NithujanSel/FarmLabCameraSlider/README.md

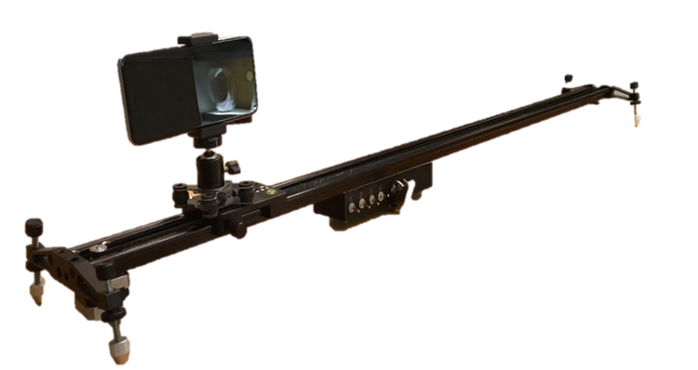
[picture p1: docs/assets/media/image1.png]


# Camera slider

### Student 1: Nithujan Selvaratnam

### Student 2: Jesse Denaux

### Student 3: Tarun Singh

<a href="https://nithujansel.github.io/FarmLabCameraSlider/">Docsify Page</a><br>
