NithujanSel/FarmLabCameraSlider/docs/README.md

# Documentatie

## Camera slider

### Student 1: Nithujan Selvaratnam

### Student 2: Jesse Denaux

### Student 3: Tarun Singh
