NithujanSel/FarmLabCameraSlider/docs/_sidebar.md

<!-- docs/_sidebar.md -->

* [Documentatie Camera slider](./documentatie/index)
