NithujanSel/FarmLabCameraSlider/docs/documentatie/index.md

# Documentatie

# Stand

De stand moet zo ontworpen zijn dat het het profiel op een bepaalde
afstand van de grond zal houden en stevig genoeg is om het geheel
stabiel te houden. Er is gekozen om dit te 3D printen zodat de
onderzoeker vrij is in het ontwerp en snel aanpassingen kan doen indien
nodig. Het eerste ontwerp was een rechthoek waar het profiel door past
met twee beentjes die naar de grond gaan voor stabiliteit. Na een eerste
revisie werd al snel besloten om de bovenste hoeken van de rechthoek af
te kappen omdat deze geen extra nut hebben en dit enkel maar langer
duurt om te printen.

## Stand 1 v1

In het eerste ontwerp is er gekeken naar de grootte van het profiel. Om
te zien dat de stand hier vlot kan inschuiven is er een marge van 0.2 mm
genomen. Het ging hier vooral over of de stand past en of dit stevig is.
Dit is ook maar met een breedte van 1 cm geprint om ervoor te zorgen dat
dit niet zolang moest printen.

<iframe
src="https://myap83.autodesk360.com/shares/public/SH35dfcQT936092f0e43ae2769a1c0cda5d8?mode=embed"
width="640" height="480" allowfullscreen="true"
webkitallowfullscreen="true" mozallowfullscreen="true"
frameborder="0"\>\</iframe>

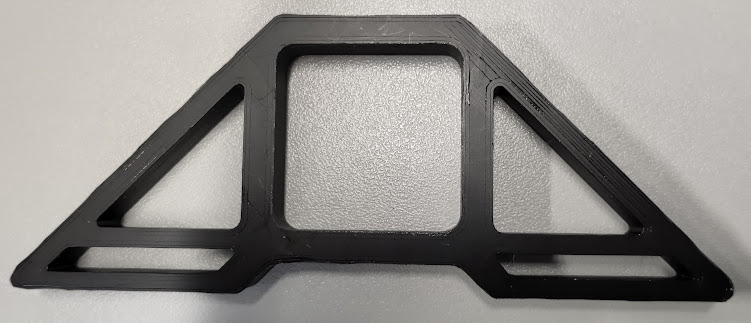
[picture p2: docs/assets/media/image2.png]
Stand 1 v1


Figuur 1: Eerste prototype profielstand 1

## Stand 1 v2

De grootte van het gat waar het profiel in past was net iets te groot.
Om dit op te lossen is het gat in de breedte en de hoogte met 0.1mm
verkleind. Voor de rest is de stevigheid van de stand perfect. Hier moet
er niets meer aan worden aangepast.

Om ervoor te zorgen dat onze slider heen en weer kan bewegen wordt er
gebruik gemaakt van een rubberen ketting. Deze ketting wordt dan met een
pulley wheel met tanden (Afbeelding 3) strak gehouden. Deze pulley wordt
aan de stand vastgemaakt. Hiervoor wordt er een kleine rechthoek op de
stand gemaakt waar de pulley in past.

<iframe
src="https://myap83.autodesk360.com/shares/public/SH35dfcQT936092f0e43b2dbe0e7d11261af?mode=embed"
width="640" height="480" allowfullscreen="true"
webkitallowfullscreen="true" mozallowfullscreen="true"
frameborder="1"\>\</iframe>

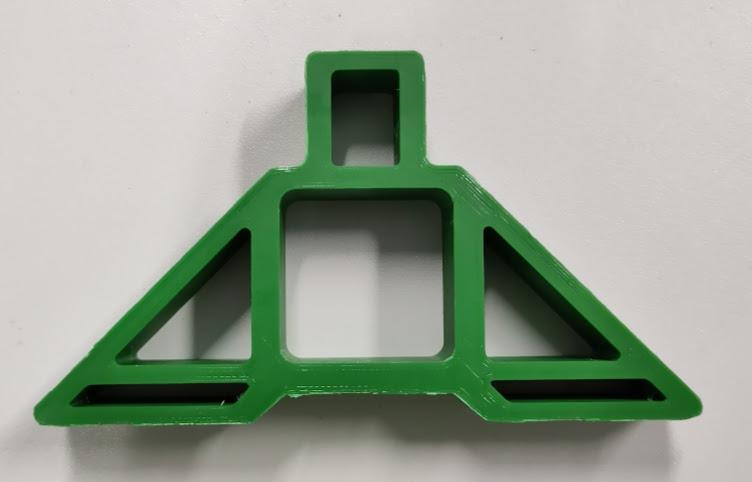
[picture p3: docs/assets/media/image3.png]
Stand 1 v2


Figuur 2: Tweede prototype profielstand 1

## Stand 1 v3

Het rechthoek van de pulley is nog net iets te groot. Hierdoor kan de
pulley een beetje in de breedte bewegen. Er is een speling van 1.87mm.
De rechthoek wordt verkleind met 1mm in de breedte zodat de pulley
minder speling heeft. De hoogte van de stand wordt 2mm groter gemaakt
zodat het profiel iets hoger van de grond is. Als laatste waren de gaten
waar de bout doorgaat om de pulley vast te hangen niet op gelijke
hoogte. Dit was een verschil van 0.2mm wat niet zo groot is maar dit was
wel zichtbaar met het oog.

Om ervoor te zorgen dat de stand aan het profiel kan worden vastgemaakt
is er in het midden aan de onderkant een gat gemaakt waar een bout door
kan. Met een moer kan dit dan aan het profiel worden vatgemaakt.

<iframe
src="https://myap83.autodesk360.com/shares/public/SH35dfcQT936092f0e43e49b220a03c161df?mode=embed"
width="640" height="480" allowfullscreen="true"
webkitallowfullscreen="true" mozallowfullscreen="true"
frameborder="0"\>\</iframe>

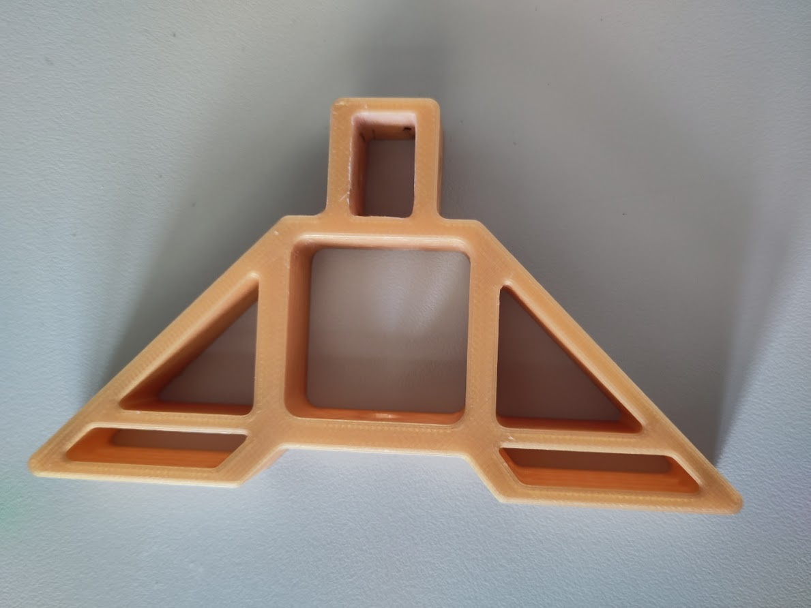
[picture p4: docs/assets/media/image4.png]
Stand 1 v3


Figuur 3: Derde prototype profielstand 1

## Stand 2 v1

Stand 2 is de stand waar de stepper motor wordt aanvast gemaakt.
Hierdoor wordt het gewicht op de slider verlaagd. Om dit te ontwerpen
wordt er verder gebouwd op stand 1 v2. Het gat van de pulley wordt wat
vergroot omdat de pulley van aan de motor is groter. Daarnaast wordt er
een plateau gemaakt waar de stepper motor op kan staan. De steppermotor
wordt bevestigd aan twee pilaren die mee op het plateau staan.

<iframe
src="https://myap83.autodesk360.com/shares/public/SH35dfcQT936092f0e43f48ecade61b5d065?mode=embed"
width="640" height="480" allowfullscreen="true"
webkitallowfullscreen="true" mozallowfullscreen="true"
frameborder="0"\>\</iframe>

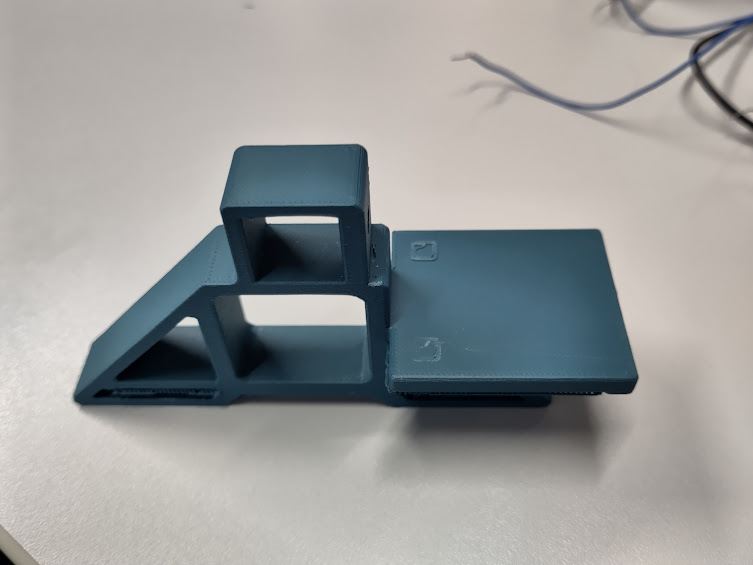
[picture p5: docs/assets/media/image5.png]


Figuur 4: Eerste prototype profielstand 2

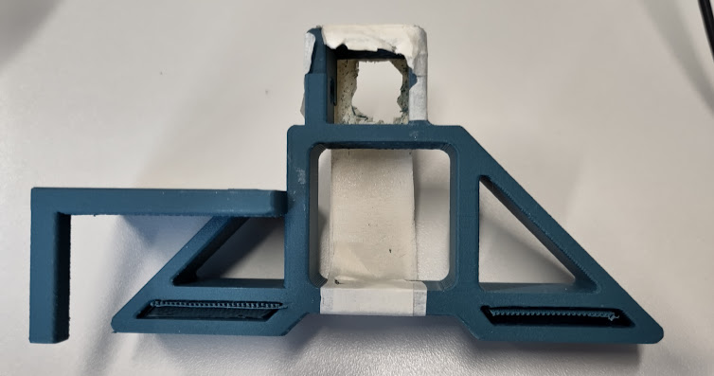
[picture p6: docs/assets/media/image6.png]


Figuur 5: Eerste prototype profielstand 2

## Stand 2 v2

Doordat het plateau breder is dan de stand, is de print richting 90
graden moeten draaien. Hierdoor was er veel support nodig. De infill was
ook maar 15% waardoor de pilaren van op het plateau niet stevig genoeg
waren. Om dit te verbeteren is er gekozen om een plaat te maken waarbij
er nog kan gekozen worden op welke plaats de stepper motor kan vast
gemaakt worden. Het plateau was nog iets te laag waardoor de stepper
motor wat zweefde.

Daarnaast is het gat waar de cilinder van de stepper motor doorgaat iets
te smal waardoor deze te veel wrijft tegen de kant wanneer de stepper
motor draait. Deze zal iets groter gemaakt moeten worden. De hoogte van
de stand wordt 2mm groter gemaakt zodat het profiel iets hoger van de
grond is.

Omdat versie 1 5u30 duurde om te printen en zeer veel support had, dit
is rechtopstaand geprint, is het printen 90 graden gedraaid waardoor dit
nog 4u30 was.

<iframe
src="https://myap83.autodesk360.com/shares/public/SH35dfcQT936092f0e439ae8add0f062906b?mode=embed"
width="640" height="480" allowfullscreen="true"
webkitallowfullscreen="true" mozallowfullscreen="true"
frameborder="0"\>\</iframe>

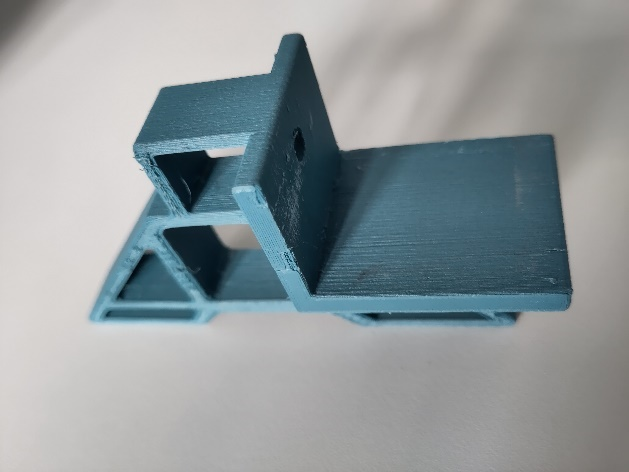
[picture p7: docs/assets/media/image7.jpeg]


Figuur 6: Tweede prototype profielstand 2

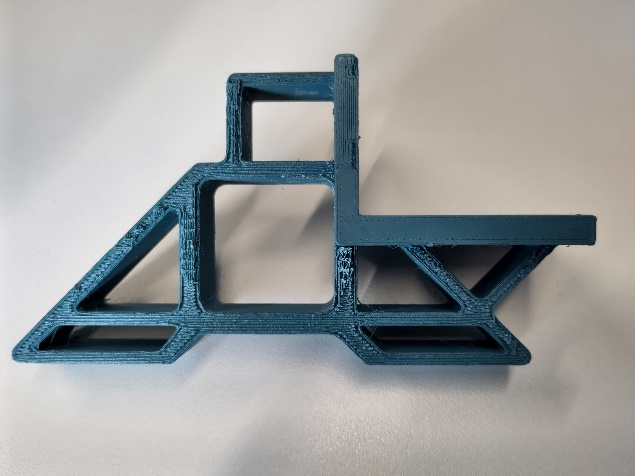
[picture p8: docs/assets/media/image8.jpeg]


Figuur 7: Tweede prototype profielstand 2

## Stand 2 v3

De plaat waar de steppermotor aan zal worden vastgemaakt was iets te
klein waardoor de bovenste schroef gaten niet in de plaat konden worden
vastgemaakt. Deze is 1cm hoger gemaakt zodat de bovenste gaten van de
stepperdriver ook konden worden vastgemaakt aan de plaat. Door een model
in te laden van de steppermotor zijn de gaten waarmee de steppermotor
wordt vastgemaakt aan de plaat exact kunnen worden gemaakt. Hierdoor
moeten deze niet achteraf worden gemaakt met onnauwkeurigheden tot
gevolg.

Ondanks dat er al 1u van de print tijd is afgegaan was dit nog zeer lang
om te printen. Na even na te denken hoe we dit nog korter konden maken
is er beslist om de gehele structuur, exclusief het plateau waar de
steppermotor opstaat en de plaat waar deze wordt aanvast gemaakt, te
verschuiven naar de buitenkant zodat deze support al weg valt. Dit heeft
ons nog eens 1u10 gespaard.

<iframe
src="https://myap83.autodesk360.com/shares/public/SH35dfcQT936092f0e4392542b71d75bd2cf?mode=embed"
width="640" height="480" allowfullscreen="true"
webkitallowfullscreen="true" mozallowfullscreen="true"
frameborder="0"\>\</iframe>

<iframe
src="https://myap83.autodesk360.com/shares/public/SH35dfcQT936092f0e43b83f0e30fe6a2534?mode=embed"
width="640" height="480" allowfullscreen="true"
webkitallowfullscreen="true" mozallowfullscreen="true"
frameborder="0"\>\</iframe>

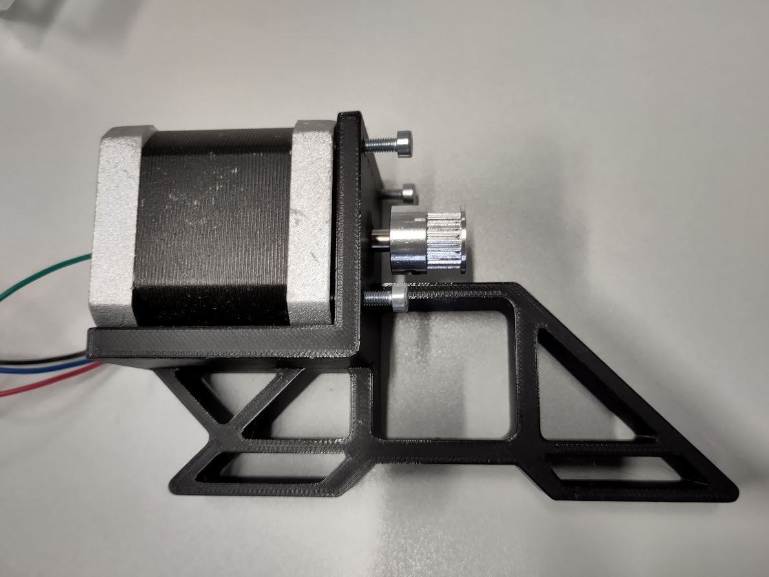
[picture p9: docs/assets/media/image9.jpeg]
A picture containing indoor Description automatically generated


Figuur 8: Derde prototype profielstand 2

# Sliderplaat

De slider dient ervoor om de ESP32-cam te dragen en via de stepper motor
op de juiste plaats te komen. De ideale slider heeft niet te veel
weerstand, waardoor de motor harder moet draaien, en is gemakkelijk
verstelbaar om de ideale hoogte en breedte te bekomen.

## Sliderplaat v1

Het eerste idee was om slider aan de bovenkant van het profiel te laten
schuiven. Om dit te bekomen zal de vorm van de slider gemaakt worden met
daarboven een plaat waar de ESP32-cam op kan gemonteerd worden.

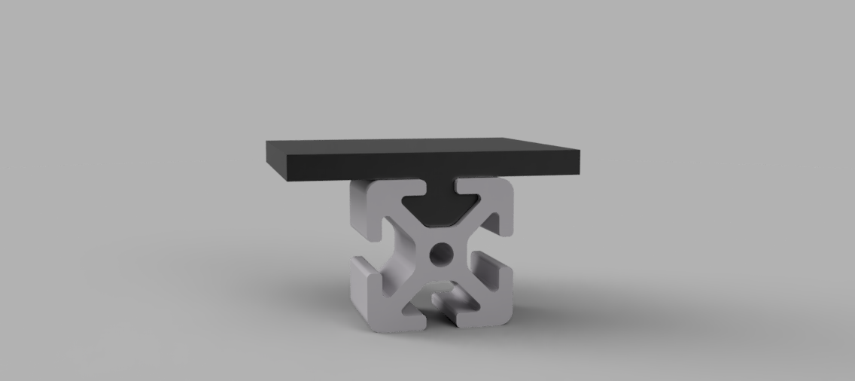
[picture p10: docs/assets/media/image10.png]
Slider v1


Figuur 9: Eerste prototype sliderplaat v1

## Sliderplaat v2

Al snel werd het duidelijk dat sliderplaat v1 heel moeilijk gaat worden
om dit met een stepper motor heen en weer te laten gaan. Er zijn
namelijk veel plaatsen waar de sliderplaat het profiel kan raken en
hierdoor de snelheid kan verliezen. Om dit te voorkomen is het idee er
gekomen om met wieltjes te werken die aan de zijkant van het profiel
zitten en dan verbonden zijn met een plaat aan de bovenkant van het
profiel.

Op de sliderplaat wordt er ook een lang horizontaal opening voorzien om
de wielen met de bouten en moeren vast te maken.

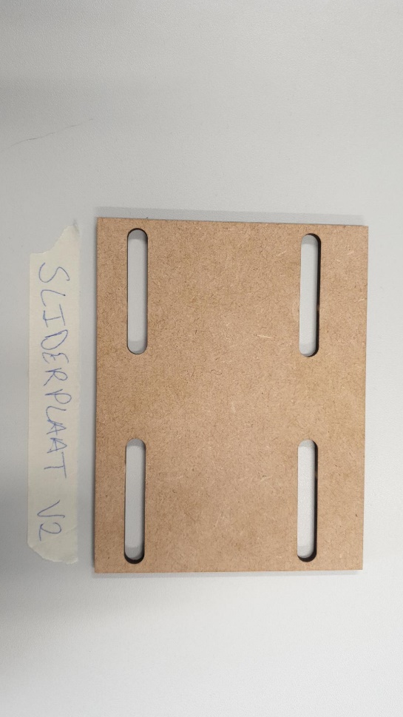
[picture p11: docs/assets/media/image11.jpeg]
Afbeelding met tekst, whiteboard Automatisch gegenereerde beschrijving


Figuur 10: Tweede prototype sliderplaat v2

<iframe src="https://student111942.autodesk360.com/shares/public/SH35dfcQT936092f0e4380715a3f6275f5af?mode=embed" width="640" height="480" allowfullscreen="true" webkitallowfullscreen="true" mozallowfullscreen="true"  frameborder="0"></iframe>

## Sliderplaat v3

De openingen bij de sliderplaat versie 2 zijn langer dan het nodig is.
Daarnaast zijn de openingen ook niet symmetrisch. Bij deze versie van de
sliderplaat wordt er nog een opening voorzien om belt vast te houden.

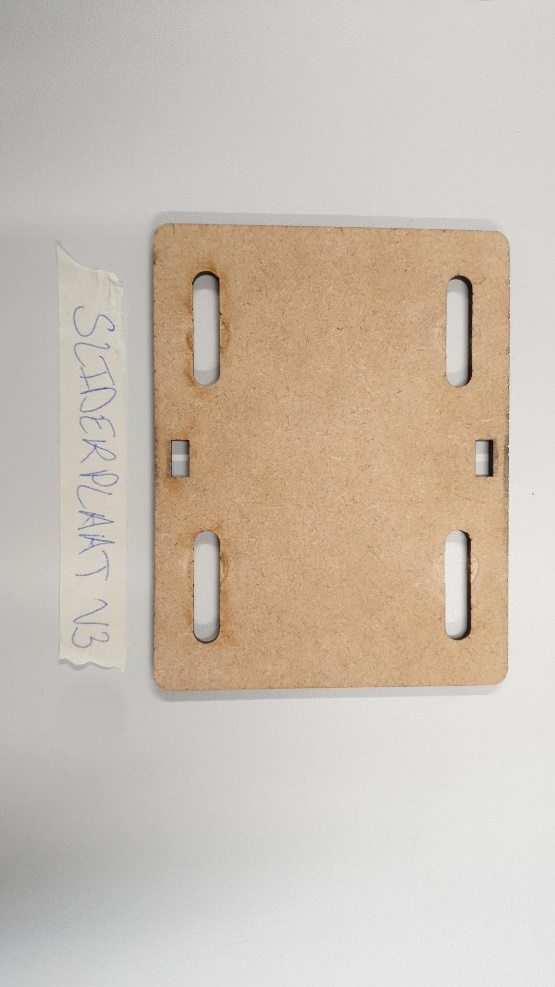
[picture p12: docs/assets/media/image12.jpeg]
Afbeelding met tekst Automatisch gegenereerde beschrijving


Figuur 11: Derde prototype sliderplaat v3

<iframe src="https://student111942.autodesk360.com/shares/public/SH35dfcQT936092f0e4342e0d105ea0a0625?mode=embed" width="640" height="480" allowfullscreen="true" webkitallowfullscreen="true" mozallowfullscreen="true"  frameborder="0"></iframe>

## Sliderplaat v4

De openingen voor de belt bij versie 3 zijn niet correct. Bovendien
blijft de belt ook niet strak genoeg waardoor de sliderplaat niet
efficiënt genoeg bewwegt met de stepper motor. Hiervoor wordt er een
beltholder ontworpen. Deze beltholder wordt ook nog verder in de
documentatie beschreven.

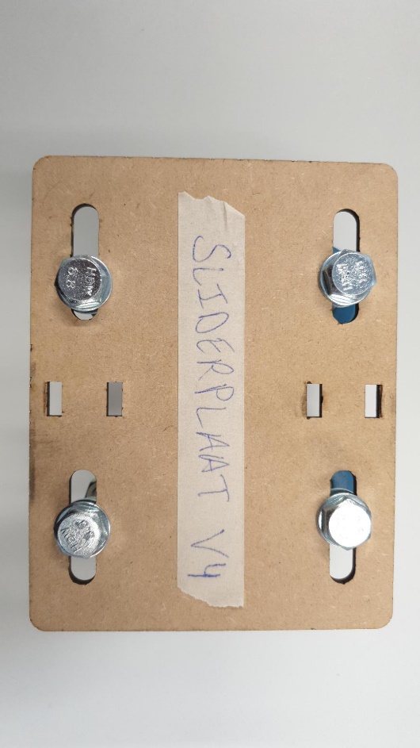
[picture p13: docs/assets/media/image13.jpeg]


Figuur 12: Vierde prototype sliderplaat v4

<iframe src="https://student111942.autodesk360.com/shares/public/SH35dfcQT936092f0e435d68fc45ffeb3f43?mode=embed" width="640" height="480" allowfullscreen="true" webkitallowfullscreen="true" mozallowfullscreen="true"  frameborder="0"></iframe>

# Wielen

De wielen zorgen ervoor dat de sliderplaat zo goed mogelijk kan
verschuiven op profiel met behulp van de stepper motor. Deze wielen zijn
dan ook verbonden met de sliderplaat.

## Wielen v1

De eerste interatie van de wielen was niet zo goed gelukt. Deze wielen
werden met een 3D printer ontworpen. De hoeken bij deze wielen zijn ook
groter dan 45 graden waardoor er support nodig was bij het 3D printen
van de wielen. Hierdoor was de ene zijde van de wiel niet glad genoeg
waardoor het wiel niet goed geleid in het profiel. Er was ook een groot
gat voorzien om een ball bearing erin te stoppen.

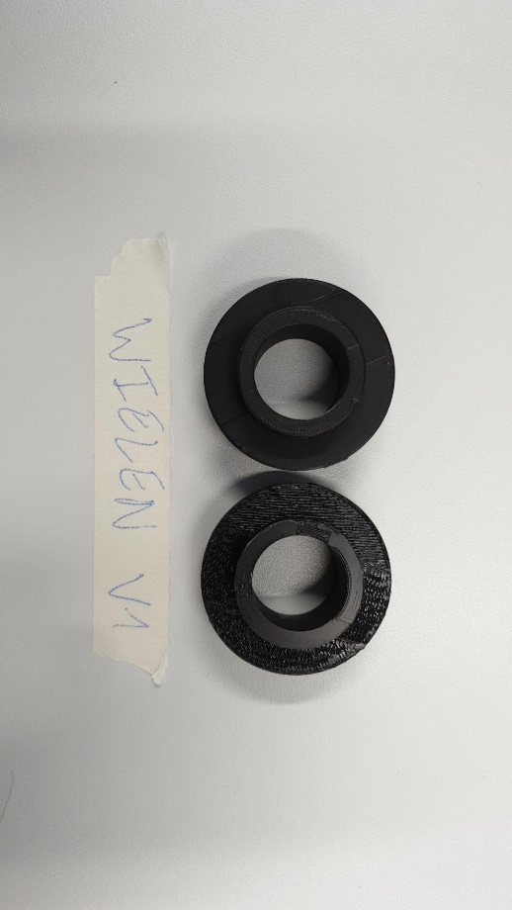
[picture p14: docs/assets/media/image14.jpeg]


Figuur 13: Eerste prototype wielen v1

<iframe src="https://student111942.autodesk360.com/shares/public/SH35dfcQT936092f0e439ec17b2efa92f148?mode=embed" width="640" height="480" allowfullscreen="true" webkitallowfullscreen="true" mozallowfullscreen="true"  frameborder="0"></iframe>

## Wielen v2

Bij deze versie wordt de hoek van de wielen 40 graden gehouden waardoor
er geen supports nodig waren bij de 3D print. De wielen gleden bij deze
versie veel beter.

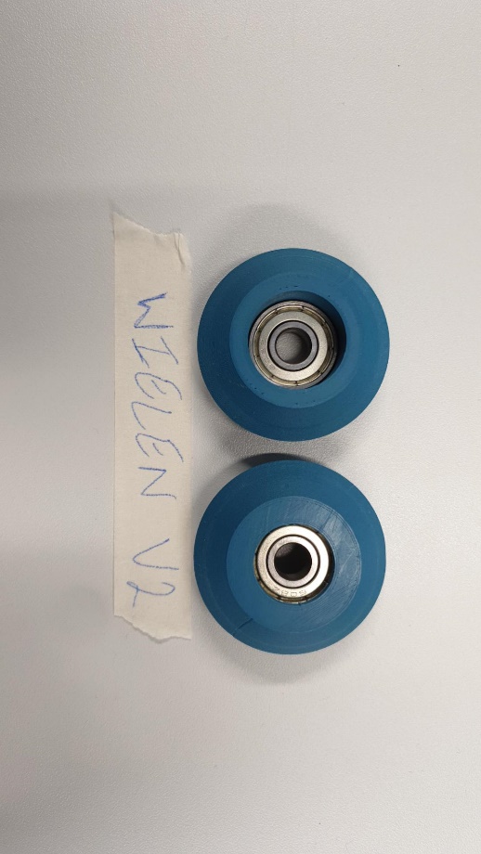
[picture p15: docs/assets/media/image15.jpeg]


Figuur 14: Tweede prototype wielen v2

<iframe src="https://student111942.autodesk360.com/shares/public/SH35dfcQT936092f0e431b1d6eca1aa3e9a6?mode=embed" width="640" height="480" allowfullscreen="true" webkitallowfullscreen="true" mozallowfullscreen="true"  frameborder="0"></iframe>

# Beltholder

Om de sliderplaat te laten bewegen met de stepper motor, heeft de
sliderplaat een beltholder nodig. De beltholder zorgt ervoor dat de belt
goed vast en strak zit.

## Beltholder v1

Het eerste idee was om de beltholder onder de sliderplaat te monteren.
Maar dit was niet goed gelukt aangezien de belt recht moet blijven en
niet zijdelings geplaatst moet worden. Hierdoor moest er een nieuw
design aangemaakt worden.

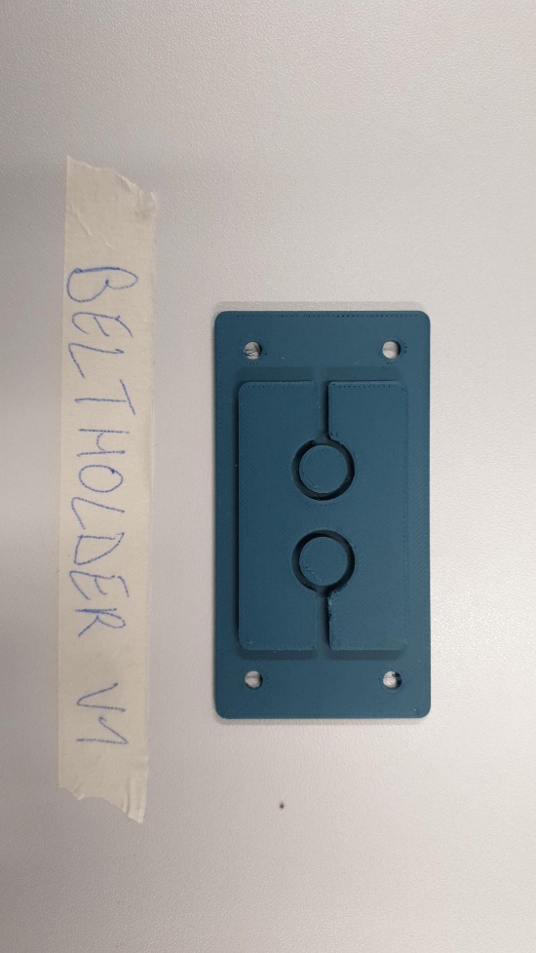
[picture p16: docs/assets/media/image16.jpeg]


Figuur 15: eerste prototype beltholder v1

<iframe src="https://student111942.autodesk360.com/shares/public/SH35dfcQT936092f0e43c360ca5dfbcf77be?mode=embed" width="640" height="480" allowfullscreen="true" webkitallowfullscreen="true" mozallowfullscreen="true"  frameborder="0"></iframe>

## Beltholder v2

Bij de versie 2 wordt de beltholder in een vorm van een rechthoek
gemaakt. Er worden ook twee klemmen gemaakt zodat deze makkelijk op de
sliderplaat geklemd kan worden. Deze beltholder was gewoon te breed en
de klemmen waren ook te klein. Omdat de klemmen niet breed genoeg waren
gingen ze kapot tijdens het inklemmen.

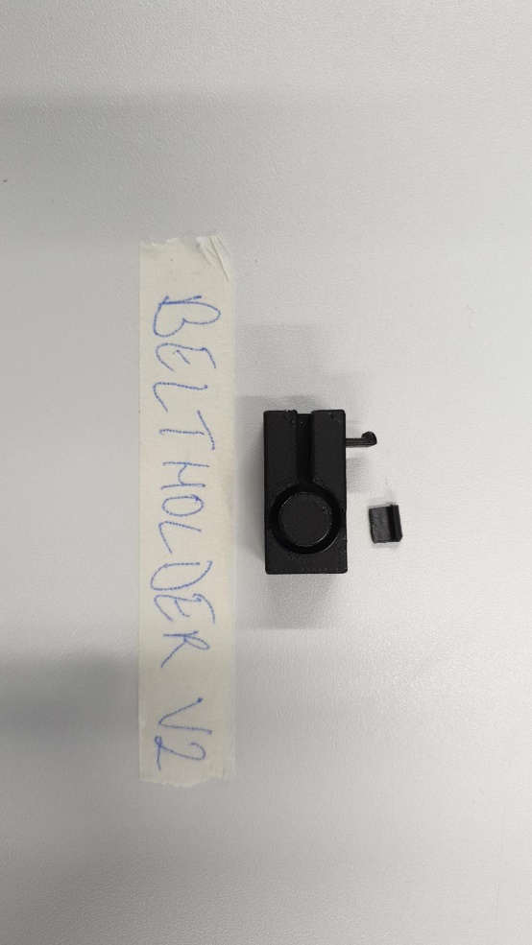
[picture p17: docs/assets/media/image17.jpeg]


Figuur 16: Tweede prototype beltholder v2

<iframe src="https://student111942.autodesk360.com/shares/public/SH35dfcQT936092f0e4329a9872ad8d497eb?mode=embed" width="640" height="480" allowfullscreen="true" webkitallowfullscreen="true" mozallowfullscreen="true"  frameborder="0"></iframe>

## Beltholder v3

Hier werd de vorige versie nog verbeterd met de afmetingen te
veranderen. Aangezien deze een goede versie is, werd er ook de linkse
reschts versie van de beltholder gemaakt.

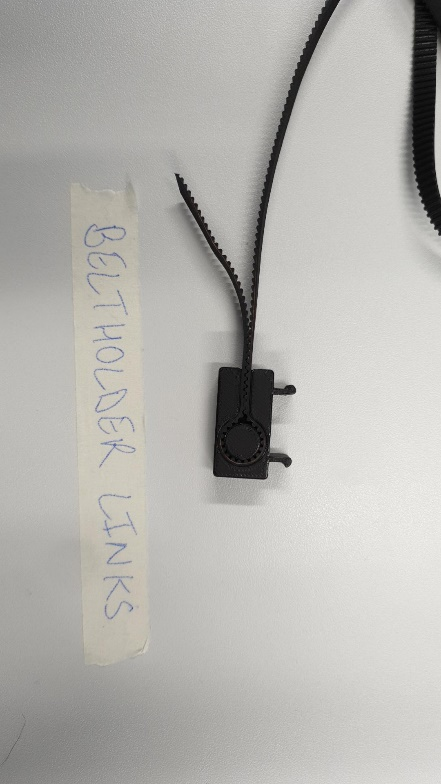
[picture p18: docs/assets/media/image18.jpeg]


Figuur 17: Derde prototype beltholder links v3

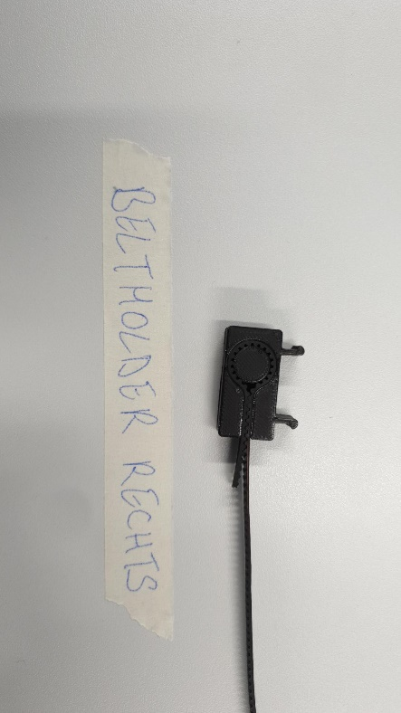
[picture p19: docs/assets/media/image19.jpeg]


Figuur 18: Derde prototype beltholder rechts v3

<iframe src="https://student111942.autodesk360.com/shares/public/SH35dfcQT936092f0e4327465fc838b768eb?mode=embed" width="640" height="480" allowfullscreen="true" webkitallowfullscreen="true" mozallowfullscreen="true"  frameborder="0"></iframe>

<iframe src="https://student111942.autodesk360.com/shares/public/SH35dfcQT936092f0e43878fc8073f3354cd?mode=embed" width="640" height="480" allowfullscreen="true" webkitallowfullscreen="true" mozallowfullscreen="true"  frameborder="0"></iframe>

## Beltholder tester

Om de juiste opening voor de klemmen te krijgen werd er een beltholder
tester ontworpen. Deze heeft meerdere openingen zodat de juiste opening
gekozen kan worden en bij de sliderplaat toegevoegd kan worden.

### Beltholder tester v1

De tester had openingen die veel te groot waren en soms veel te smal
waren waardoor de klemmen van belthoder niet goed vast zaten in de
tester.

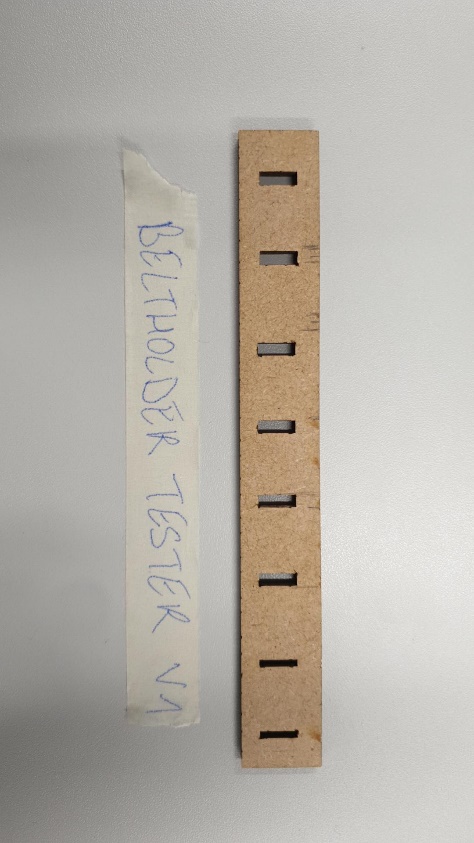
[picture p20: docs/assets/media/image20.jpeg]


Figuur 19: Eerste prototype beltholder tester v1

### Beltholder tester v2

Bij deze versie werden de exacte afmetingen genomen van beltholder en
bij elke nieuwe opening werd de opening 0.2 mm vergroot.

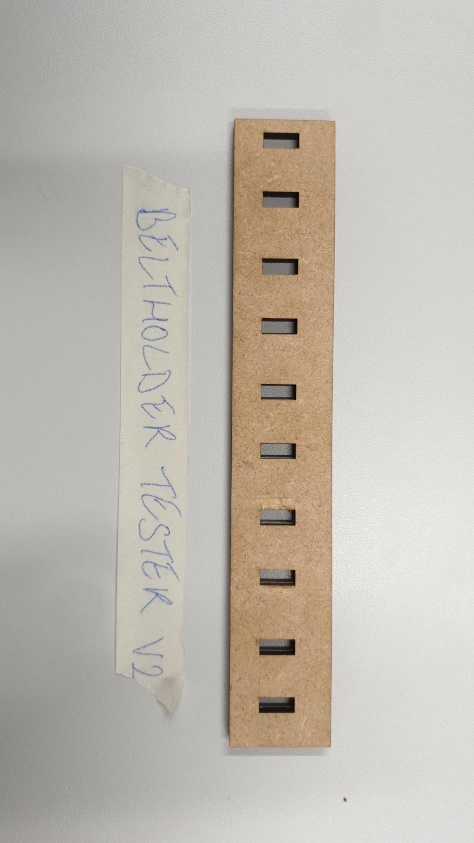
[picture p21: docs/assets/media/image21.jpeg]


Figuur 20: Tweede prototype beltholder testser v2

## Bouten en moeren

Onderstaande tabel toont aan welke producten er gebruikt werden bij het
maken van de sliderplaat.

| Product | Aantal | grootte |
|---|---|---|
| Bout | 4 | M8X100  |
| Rondel  | 8 | M8 |
| Moer | 12 | M8 |

# Pan en Tilt Systeem

## Camera

De keuze van de camera was niet zo moeilijk. De camera die wordt
gebruikt bij de camera slider is de ESP32-CAM. Het is en klein en een
compacte module. De kwaliteit van de camera is voldoende voor de huidige
toepasing. Daarnaast gebruikt deze ook niet zo veel energie. Dat is
perfect want de ESP32-CAM zal met batterijen werken die opgeladen zullen
worden door middel van een oplaadbaar station.

Voor het maken van een pan en tilt systeem wordt er gebruik gemaakt van
twee servo moteren. Eén voor de pan en andere voor de tilt. Deze motoren
zijn compact en hebben voldoende kracht om de ESP32-CAM te laten
bewegen.

Daarom werd er gekozen voor servo motoren. Hieronder worden andere
redenen aangegeven waarom de servo motor een goede optie is:

- Ze zijn klein.

- Hebben genoeg kracht om de ESP32-CAM te laten bewegen

- Makkelijk te programmeren.

- Heeft niet zoveel vermogen nodig.

- Servo motor heeft geen driver nodig.

## 3D Model voor pan en tilt

Om de pan en tilt motor te laten werken wordt er een 3D model voorzien.
Op dit 3D model wordt de ESP32-CAM bevestigd. Het 3D model is gevonden
op het internet (Thingiverse.com, z.d.). Hier onder staan de foto’s van
het model:

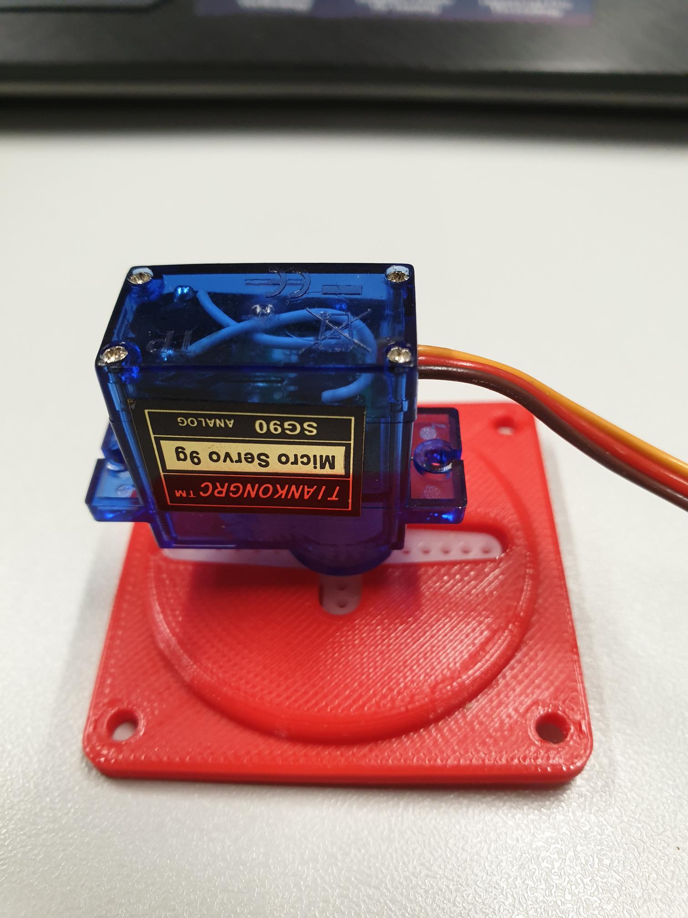
[picture p22: docs/assets/media/image22.png]
Afbeelding met kist, accessoire Automatisch gegenereerde beschrijving


Figuur 21: Pan geprint 3D model met servo

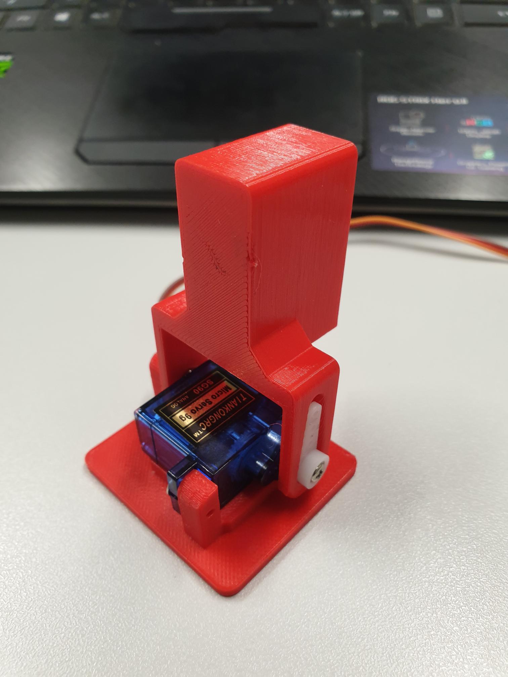
[picture p23: docs/assets/media/image23.png]
Afbeelding met rood Automatisch gegenereerde beschrijving


Figuur 22: Tilt geprint 3D model met servo

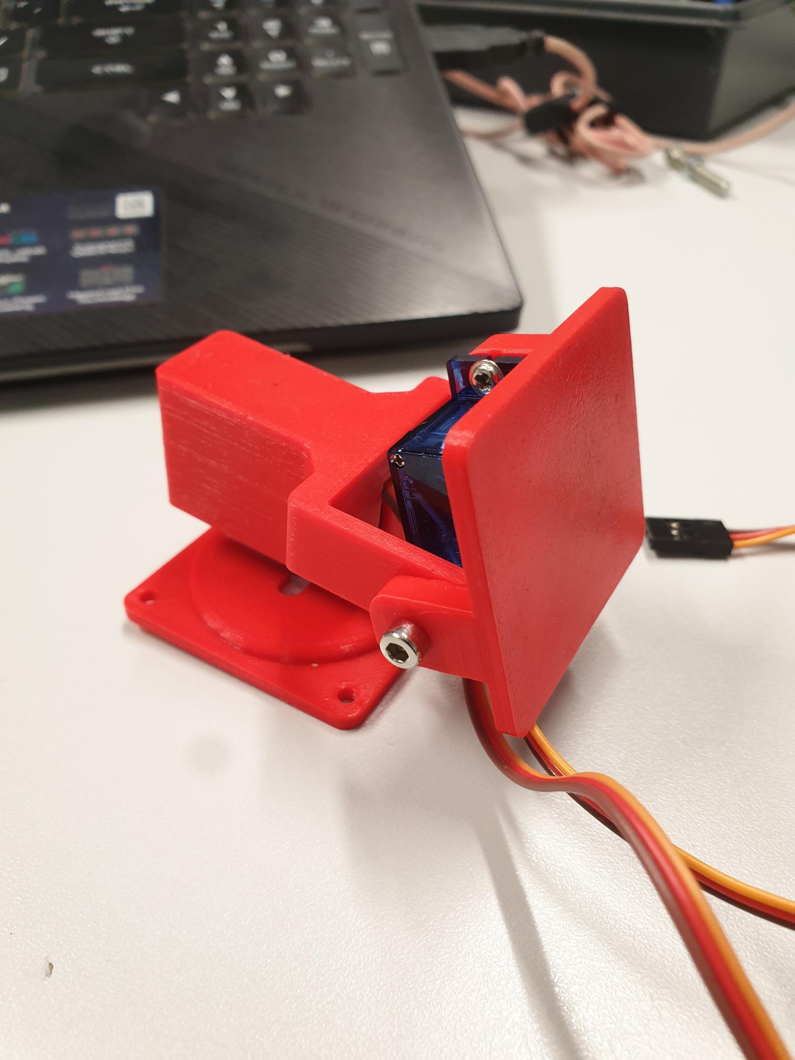
[picture p24: docs/assets/media/image24.png]
Afbeelding met kantoorartikelen Automatisch gegenereerde beschrijving


Figuur 23: Gemonteerd geprint 3D model

Bovenstaande foto’s geven aan dat het gevonden 3D model goed past met de
servo motoren. Hierdoor was het niet nodig om zelf een nieuw model te
maken of aanpassingen aan te brengen.

## Elektrisch schema

Om de ESP32-CAM gemakkelijk te monteren is er een shield gemaakt. In
onderstaand schema is er een pinout voor de servo’s aanwezig. Er zijn
ook program pinnen om met ESP32- te communiceren.

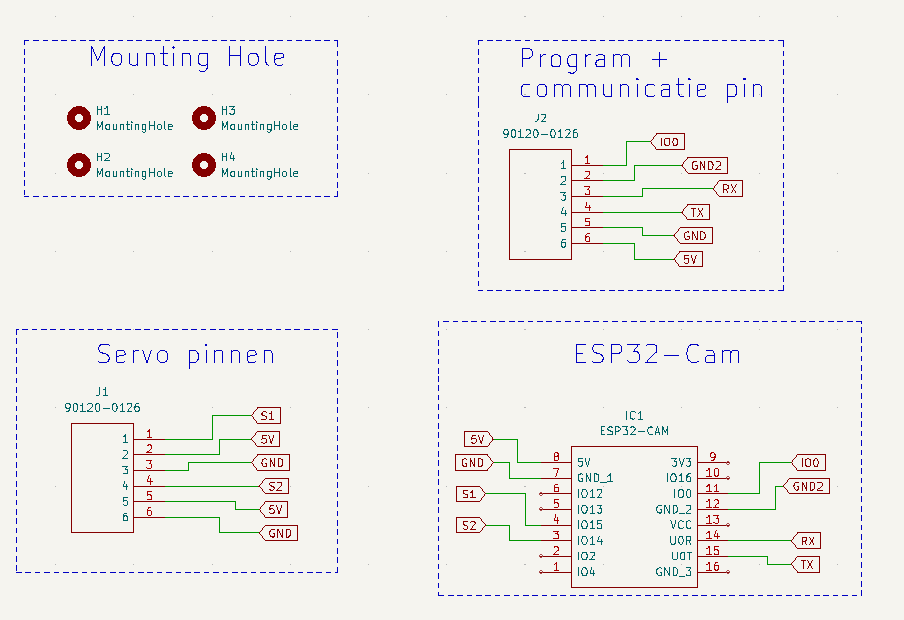
[picture p25: docs/assets/media/image30.png]


Figuur 29: Elektrische schema van ESP32-CAM shield

## PCB

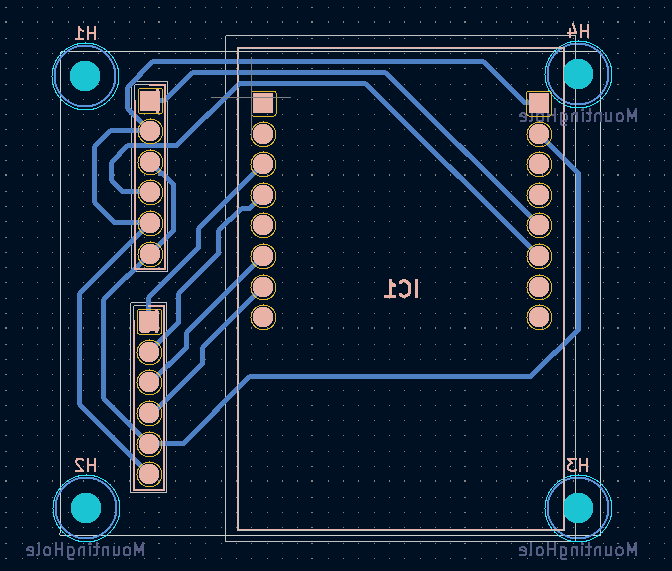
[picture p26: docs/assets/media/image31.png]
Afbeelding met tekst, elektronica Automatisch gegenereerde beschrijving


Figuur 30: PCB ESP32-CAM shield Schema

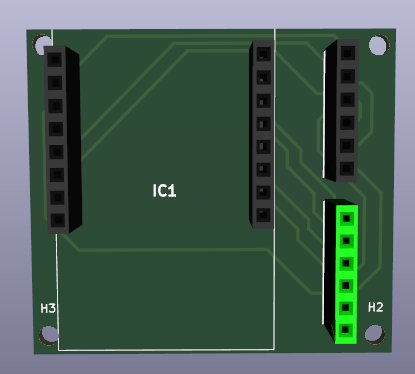
[picture p27: docs/assets/media/image32.png]


Figuur 31: PCB 3D model van ESP32-CAM shield

## Gefreesde PCB’s

### Versie 1:

Bij versie 1 was de frees machine niet zo goed gekalibreerd waardoor die
de paden verkeerd ging frezen. Soms was de boor niet hoog genoeg
opgetild waar door die verkeerd ging frezen.

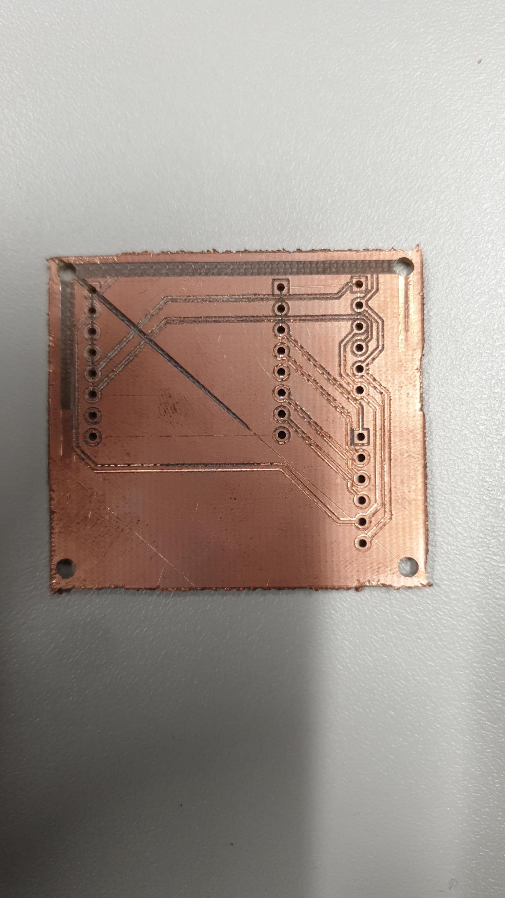
[picture p28: docs/assets/media/image33.png]


Figuur 32: ESP32-CAM Shield V1

### Versie 2:

Bij versie 2 waren de paden niet zo goed gefreesd waar door er
kortsluiting was. De frees machine heeft wel goed gefreesd deze keer.

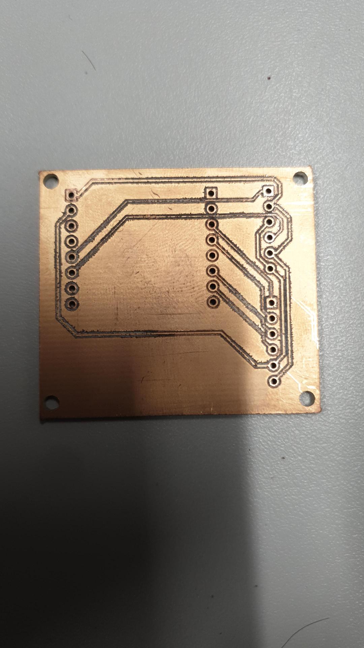
[picture p29: docs/assets/media/image34.png]


Figuur 33: ESP32-CAM Shield V2

### Versie 3:

Bij versie 3 was de top en bottom omgewisseld waar door de camera pinnen
omgekeerd waren.

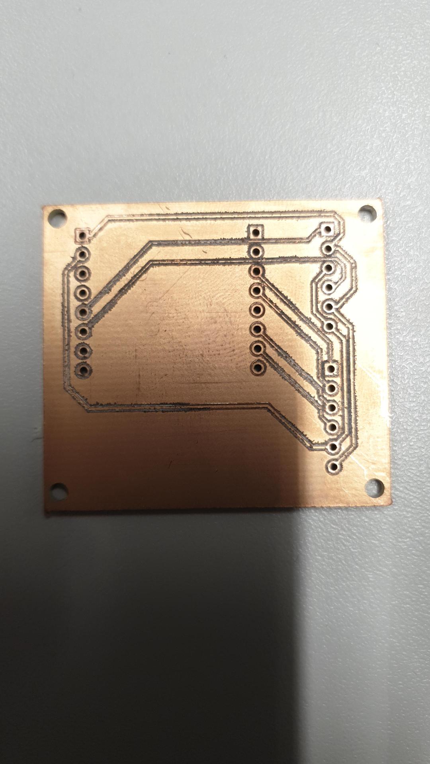
[picture p30: docs/assets/media/image35.png]
Afbeelding met tekst, kist Automatisch gegenereerde beschrijving


Figuur 34: ESP32-CAM Shield V3

# Web interface

Het controleren van de camera, stepper motor en de servo’s gebeurt met
een interface. Daarom is er een Node-Red interface aangemaakt waar men
deze kan controleren. De huidige interface heeft alleen de manuele modus
en nog geen automatische modus.

De interface heeft twee sliders. Eén is voor de pan en de andere is voor
de tilt. Als de slider wordt verschoven gaat de Node-Red, via MQTT
communicatie, met de ESP32-CAM communiceren en de servo’s laten bewegen.

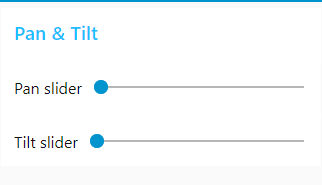
[picture p31: docs/assets/media/image25.png]


Figuur 24: Interface Pan en Tilt:

Er zijn twee modi om een foto te nemen. Eén met flits en één zonder
flits. Afhankelijk van de situatie kan men één van de twee modi kiezen.
Hieronder ziet u een voorbeeld van de interface. Er is ook een
kalibratie knop om de ESP32-CAM te kalibreren. Dit is nodig omdat er bij
de eerste keer er een foto wordt genomen deze er niet zo goed uitziet.
Om dit op te lossen moet de camera worden gekalibreerd.

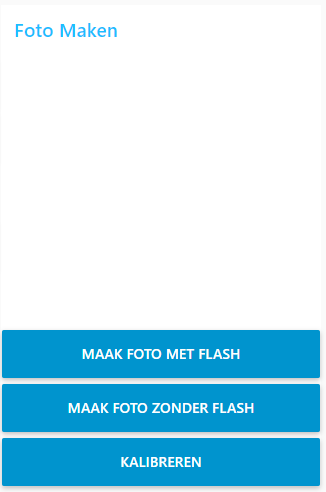
[picture p32: docs/assets/media/image26.png]


Figuur 25: Interface van ESP32-CAM.

De foto die worden getrokken worden voorlopig opgeslagen op de lokale
server. Later wordt dat omgezet naar de bletchley server. Wanneer er een
foto wordt getrokken gaat de Node-Red deze foto in een folder opslagen.
De naam van de foto en de folder is de datum waarop de foto is gemaakt.

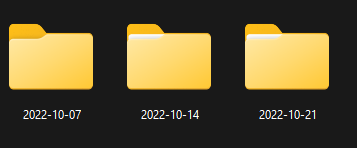
[picture p33: docs/assets/media/image27.png]


Figuur 26: Foto opslag folder van de interface

De stepper motor interface heeft een optie om de slider naar links en
rechts te bewegen. Er is ook de mogelijkheid om snelheid aan te passen
en de motor stop te zetten. Voorlopig kan de stepper motor niets
automatisch doen.

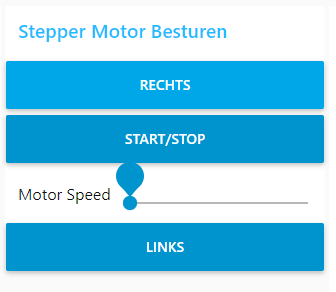
[picture p34: docs/assets/media/image28.png]


Figuur 27: Interface stepper motor

In onderstaande afbeelding is de volledige interface van de webpagina te
zien.

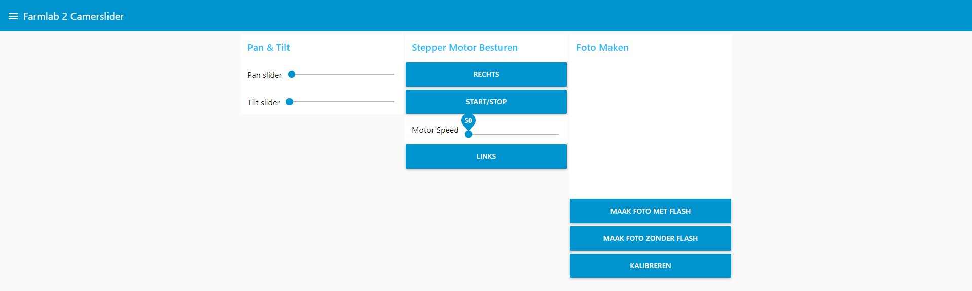
[picture p35: docs/assets/media/image29.png]


Figuur 28: Volledige interface van de webpagina

# Docker

Installeren van Docker via de site:
<https://docs.docker.com/desktop/install/windows-install/>. (“Install
Docker Desktop on Windows”, 2022) Zie dat er een linux kernel aanwezig
is op de Windows machine om de WSL 2 versie als default te zetten.
(“Manual installation steps for older versions of WSL”, 2022) Stappen 4
en 5 moet worden uitgevoerd. Anders krijgt men volgende error bij het
opstarten.

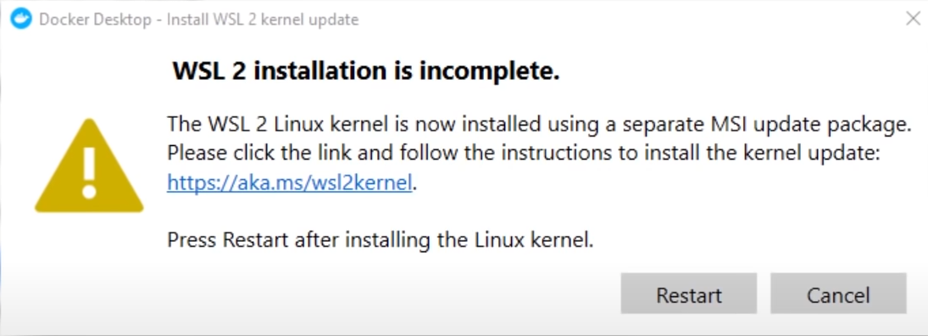
[picture p36: docs/assets/media/image36.png]
Graphical user interface, text, application, email Description automatically generated


Figuur 35: Error bij opstarten Docker zonder gepaste Linux kernel.

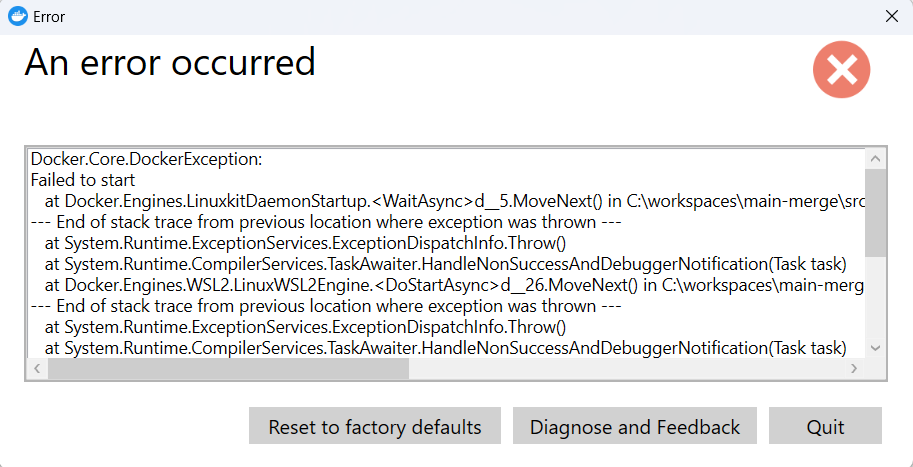
[picture p37: docs/assets/media/image37.png]
Graphical user interface, text, application Description automatically generated


Figuur 36: Error bij opstarten Docker zonder activeren juiste Linux kernel
versie.

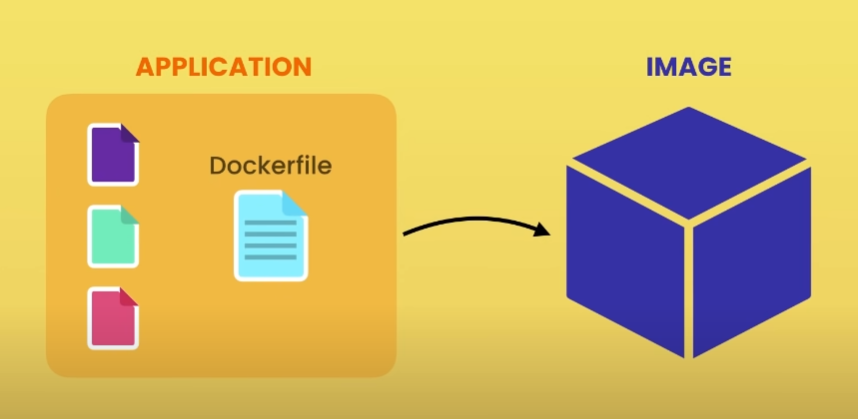
[picture p38: docs/assets/media/image38.png]
Diagram Description automatically generated


Figuur 37: Diagram over hoe een image in docker wordt gemaakt.
(Programming with Mosh, 2021)

Docker is een programma waarbij er gemakkelijk geschreven programma’s op
verschillende computers kunnen worden gedraaid zonder dat al de packages
en dergelijke afzonderlijk moeten worden geïnstalleerd. Docker maakt van
de code, de packages en alles er rond een image wat dan wordt opgeslagen
in de docker hub.

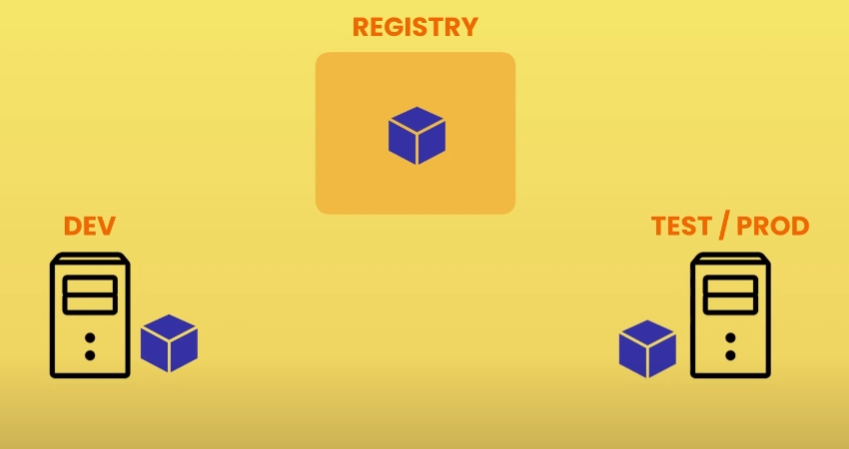
[picture p39: docs/assets/media/image39.png]
A picture containing text, first-aid kit, vector graphics, screenshot Description automatically generated


Figuur 38: Diagram van hoe een image op verschillende copmuters kan
draaien. (Programming with Mosh, 2021)

Wil men dit dan op een andere computer draaien dan hoeft men enkel de
image te downloaden met de bijhorende packages en dergelijke en kan men
het programma zonder problemen runnen.

# Tests 

## Test 1: Motor driver op klein profiel

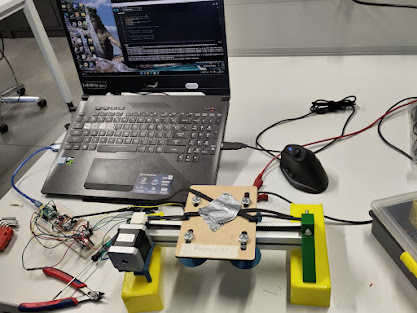
[picture p40: docs/assets/media/image40.jpeg]
A picture containing text, indoor, cluttered Description automatically generated


Figuur 39: Setup slider met profiel 30cm:

<https://photos.google.com/album/AF1QipNc2HlqLKLi-fJn4t2gWh2M19e81hADS3dtTNHV/photo/AF1QipNZe_BSFLD73aJ8lfxFqyDM48WOiNvx0hnSvb2D>

De eerste test is een test om te kijken of het hard programmeren van de
stepper motor werkt op een profiel van 30cm. Alles is nog verbonden met
computer en de labovoeding.

De test is succesvol uitgevoerd en de code werkt naar behoren.

## Test 1.1: Snelheid slider

<https://photos.app.goo.gl/mnk9MxC7bvREfgSE7>

<https://photos.app.goo.gl/yRQxuTXK1qLKk3848>

<https://photos.app.goo.gl/yRQxuTXK1qLKk3848>

In deze test is er gekeken op welke manier de slider het beste beweegt
over het profiel. Hierdoor komt men te weten hoe men de slider best
plaatst op het profiel met zo weinig mogelijk weerstand.

Na enkele tests op tijd kan er geconcludeerd worden dat het plaatsten
van de slider verticaal of langs onder op het profiel beter is dan langs
boven. Dit valt natuurlijk met een korreltje zout te nemen aangezien het
hier over een test gaat met de zwaartekracht en dat de wieltjes van de
slider op dezelfde hoogte moeten geplaatst worden om zo weinig mogelijk
schommelen van de slider te krijgen.

De snelheid waarmee de slider over het profiel beweegt is ook veel te
snel voor hoe het in het uiteindelijke model gaat zijn maar dit geeft
wel een goede representatie van of de slider in een foute richting
beweegt of ergens te veel wrijving veroorzaakt. Dit zou het stroom
verbruik kunnen verhogen.

## Test 2: Motor driver op 3m profile aangestuurd met Node-red

<https://photos.app.goo.gl/ja1oeATHVVT5JXBd9>

<https://photos.app.goo.gl/M8mrGXpsKZv4E4em8>

Er wordt hier getest of de slider kan worden aangestuurd via de Node-red
applicatie. Zoals in de filmpjes te zien werkt dit naar behoren en kan
de snelheid worden aangepast. Dit zal in het uiteindelijke model niet
het geval zijn maar op deze manier kan er een duidelijk beeld gecreëerd
worden over hoe snel de camera tussen de plantjes in kan bewegen.

# Bronvermelding

Thingiverse.com. (2015, 4 maart). Mini Pan Tilt - Servo G9 by fbuenonet.
Geraadpleegd op 27 september 2022, van
<https://www.thingiverse.com/thing:708819>

Programming with Mosh. (2021, 30 maart). *Docker Tutorial for Beginners*
\[Video\]. Geraadpleegd op 28 oktober 2022, van
https://www.youtube.com/watch?v=pTFZFxd4hOI

Education, I. C. (2022, 17 juni). *Docker*. Geraadpleegd op 28 oktober
2022, van https://www.ibm.com/cloud/learn/docker

*Overview*. (2022, 28 oktober). Geraadpleegd op 28 oktober 2022, van
<https://docs.docker.com/desktop/use-desktop/>

*Manual installation steps for older versions of WSL*. (2022, 27 juni).
Geraadpleegd op 28 oktober 2022, van
https://learn.microsoft.com/en-gb/windows/wsl/install-manual

*Install Docker Desktop on Windows*. (2022, 28 oktober). Geraadpleegd op
28 oktober 2022, van
https://docs.docker.com/desktop/install/windows-install/

Cooke, A. C. (2017). Camera Slider. Geraadpleegd van https://cdn.fstoppers.com/styles/large-16-9/s3/lead/2017/03/diy-camera-slider_0.jpg
