NithujanSel/FarmLabCameraSlider/hardware/pcb/ESPCamPCB.kicad_pcb

## KiCad design hardware/pcb/ESPCamPCB.kicad_pcb (2022-10-28)

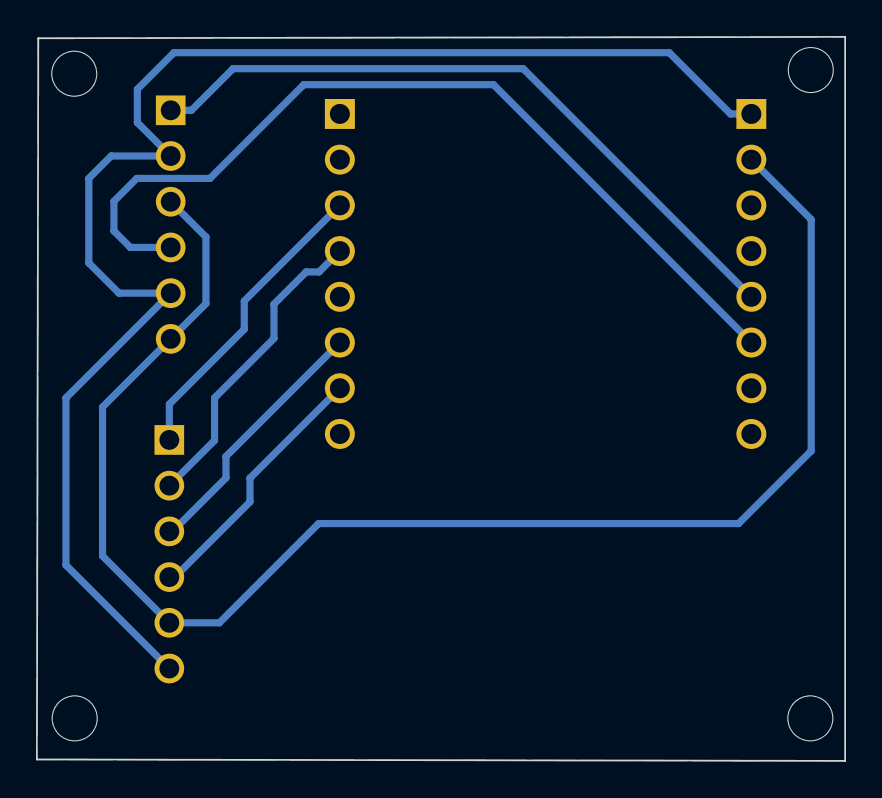
[picture p41: board ESPCamPCB.kicad_pcb from above]

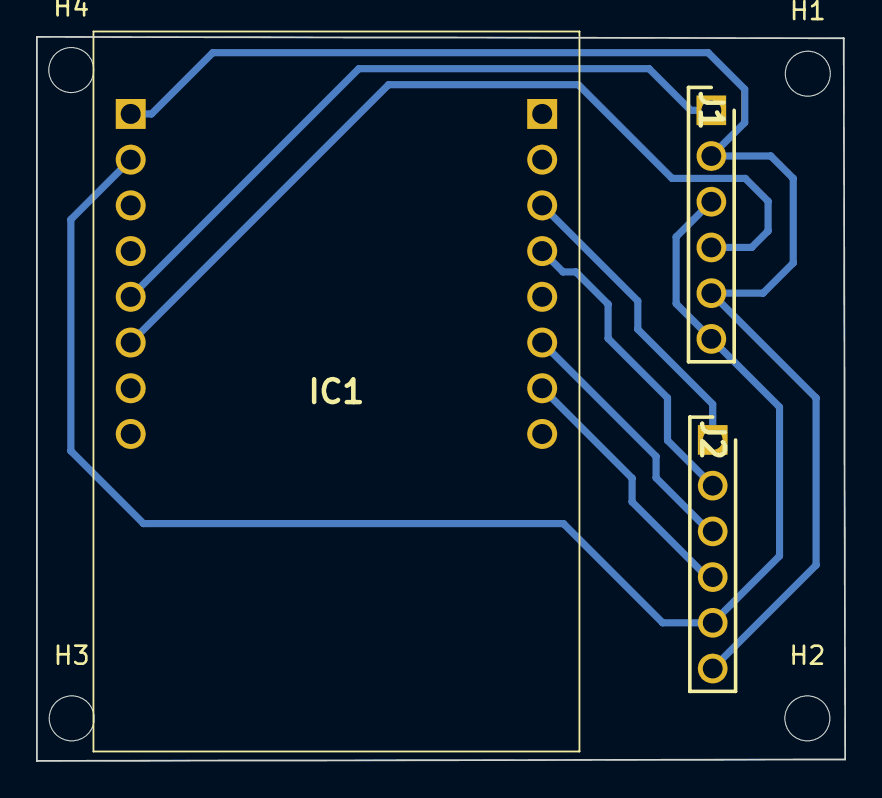
[picture p42: board ESPCamPCB.kicad_pcb from below]

Board: 2 copper layers, 44.9 x 40.2 mm, 7 parts (7 on the bottom side), 8 nets.

Parts:
H1, H2, H3, H4: MountingHole; MountingHole_2.5mm
IC1: ESP32-CAM; ESP32CAM
J1, J2: 90120-0126; HDRV6W65P0X254_1X6_1502X249X560P

Connections:
5V: IC1.8 (5V), J1.2, J1.5, J2.6
GND: IC1.7 (GND_1), J1.3, J1.6, J2.5
GND2: IC1.12 (GND_2), J2.2
IO0: IC1.11 (IO0), J2.1
RX: IC1.14 (U0R), J2.3
S1: IC1.4 (IO15), J1.1
S2: IC1.3 (IO14), J1.4
TX: IC1.15 (U0T), J2.4
